fgmourao/Conditioning_Chamber/Images/15.jpeg

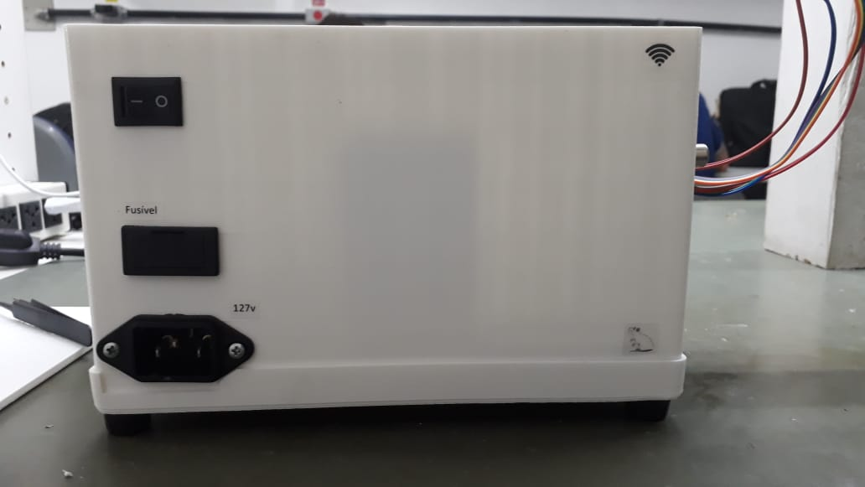
Images/15.jpeg
