fgmourao/Conditioning_Chamber/Images/17.jpeg

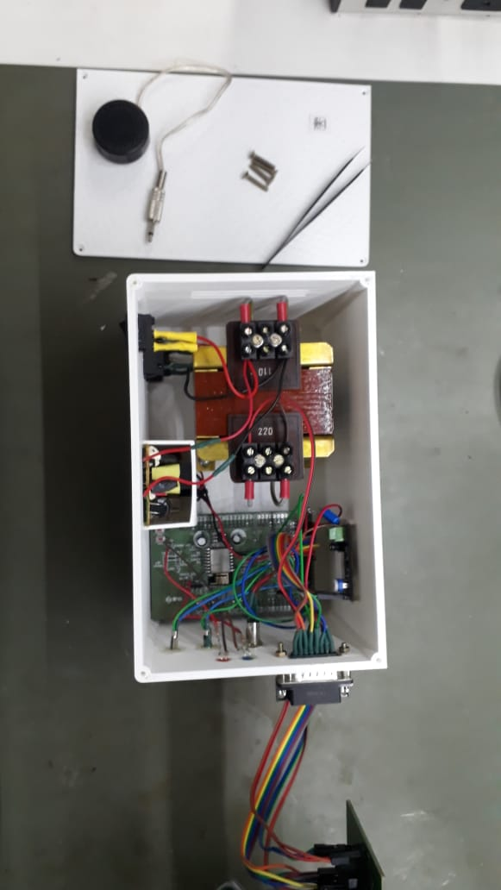
Images/17.jpeg
