fgmourao/Conditioning_Chamber/README.md

# A Custom Microcontrolled and Wireless-Operated Chamber for Auditory Fear Conditioning

Front. Neurosci., 07 November 2019<br />
Sec. Neural Technology <br />
https://doi.org/10.3389/fnins.2019.01193<br />

Correspondence:<br />

Flávio Afonso Gonçalves Mourão, PhD<br />
Núcleo de Neurociências, Departamento de Fisiologia e Biofísica<br />
Instituto de Ciências Biológicas (ICB)<br /> 
Universidade Federal de Minas Gerais (UFMG)<br />
Av. Antônio Carlos, 6627 - CEP 31270-901- Campus Pampulha<br />
Belo Horizonte - MG - Brazil<br />
Fax: +55 31 3409-2924 Phone: +55 31 3409-2927<br />
Email:  mourao.fg@gmail.com / fagm@ufmg.br <br />

Márcio Flávio Dutra Moraes, PhD<br />
Núcleo de Neurociências, Departamento de Fisiologia e Biofísica<br />
Instituto de Ciências Biológicas (ICB)<br /> 
Universidade Federal de Minas Gerais (UFMG)<br />
Av. Antônio Carlos, 6627 - CEP 31270-901- Campus Pampulha<br />
Belo Horizonte - MG - Brazil<br />
Fax: +55 31 3409-2924 Phone: +55 31 3409-2930<br />
Email: mfdm@icb.ufmg.br <br />
<br />
