fgmourao/Conditioning_Chamber/Images/02.jpeg

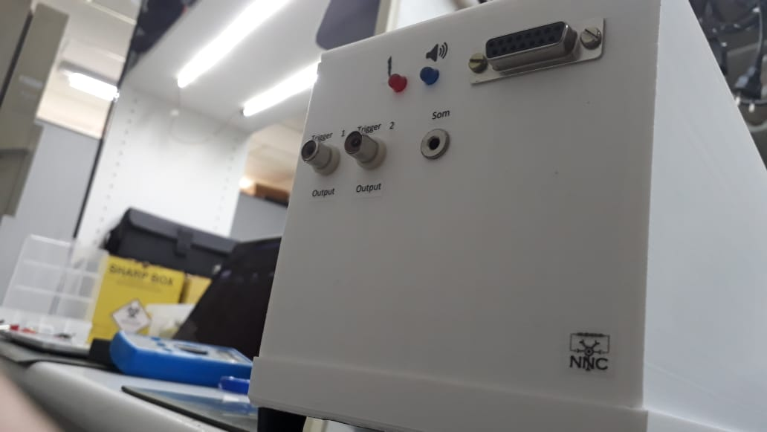
Images/02.jpeg
