fgmourao/Conditioning_Chamber/Images/03.jpeg

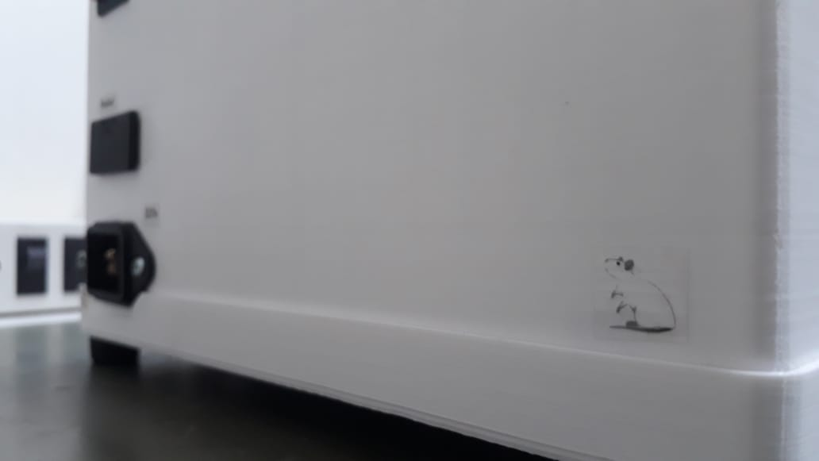
Images/03.jpeg
