fgmourao/Conditioning_Chamber/Images/04.jpeg

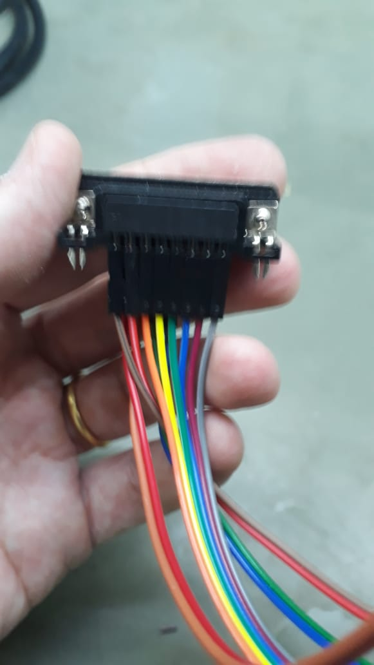
Images/04.jpeg
