fgmourao/Conditioning_Chamber/Images/06.jpeg

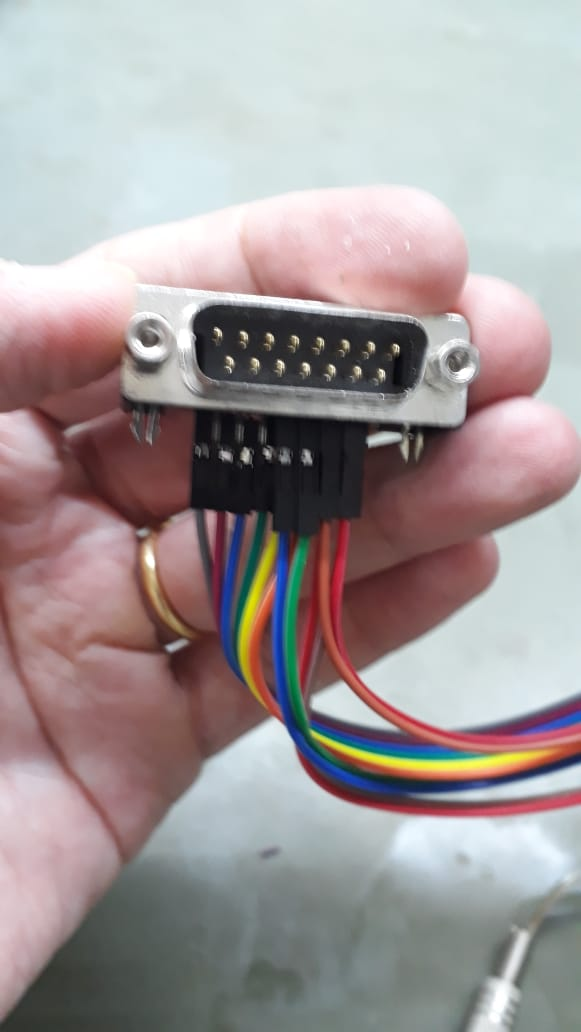
Images/06.jpeg
