fgmourao/Conditioning_Chamber/Images/11.jpeg

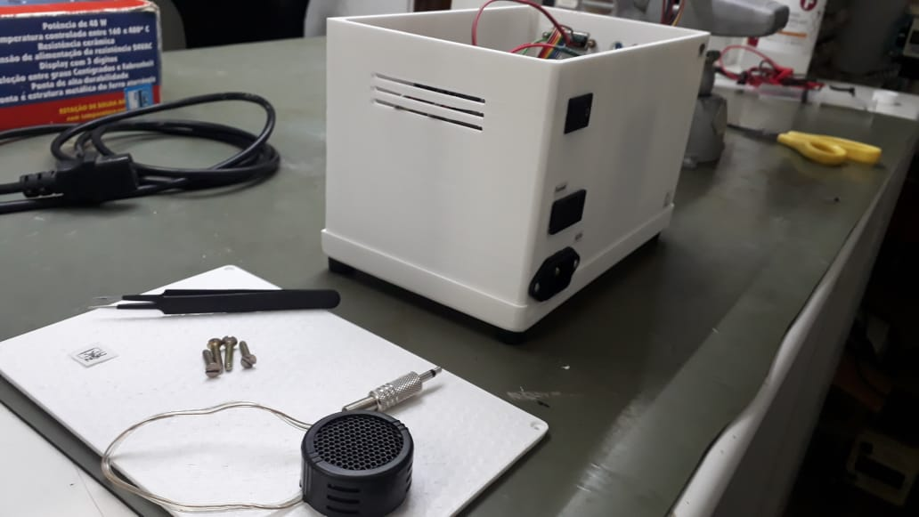
Images/11.jpeg
