fgmourao/Conditioning_Chamber/Images/12.jpeg

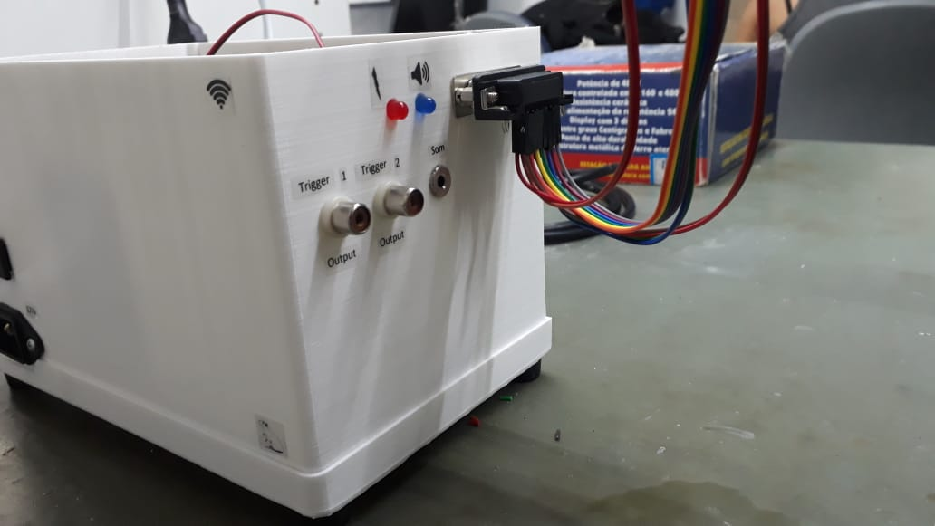
Images/12.jpeg
