fgmourao/Conditioning_Chamber/Images/13.jpeg

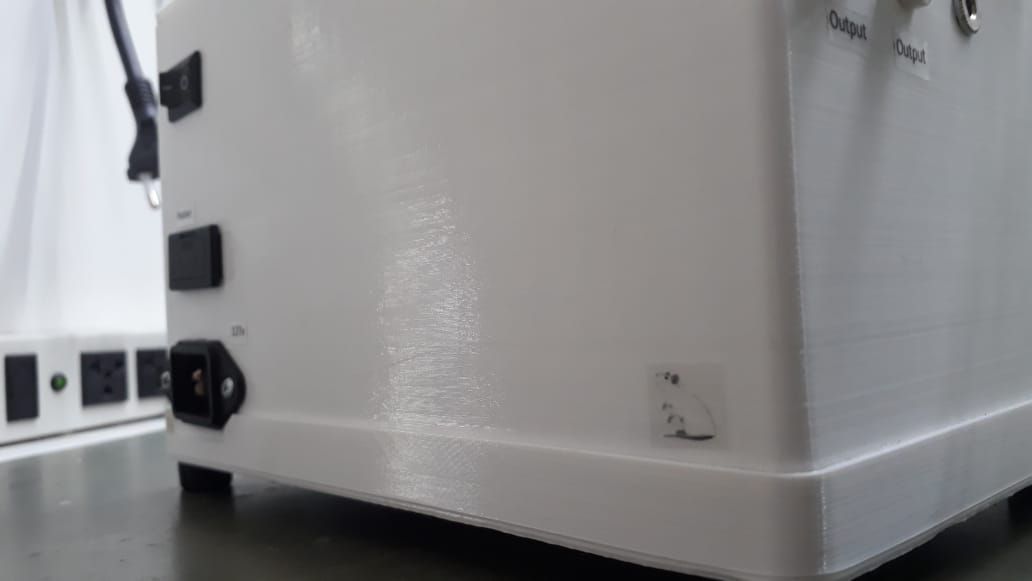
Images/13.jpeg
