fgmourao/Conditioning_Chamber/Images/14.jpeg

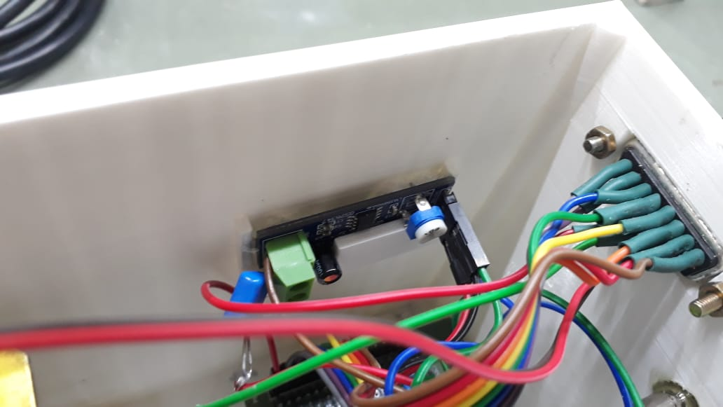
Images/14.jpeg
