fgmourao/Conditioning_Chamber/Hardware/3D/Control_box.stl

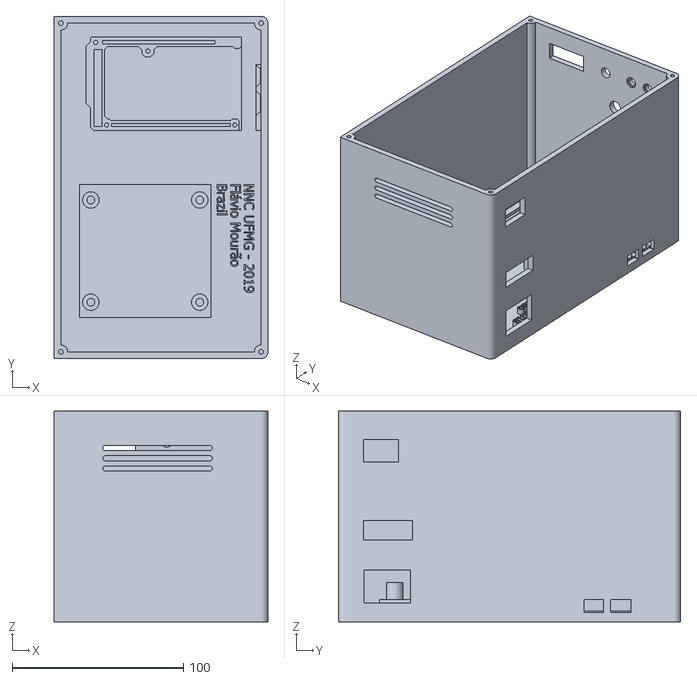
[picture p11: CAD file, 2023-06-27]
Hardware/3D/Control_box.stl
125.0 x 200.0 x 123.0
