fgmourao/Conditioning_Chamber/Hardware/3D/Control_box_roof.stl

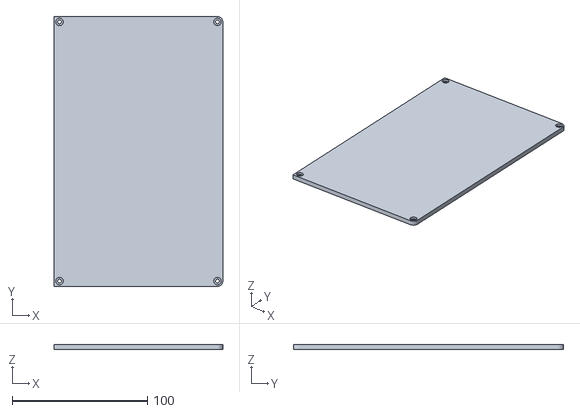
[picture p12: CAD file, 2023-06-27]
Hardware/3D/Control_box_roof.stl
125.0 x 200.0 x 3.80
