fgmourao/Conditioning_Chamber/Hardware/3D/Control_box_floor.stl

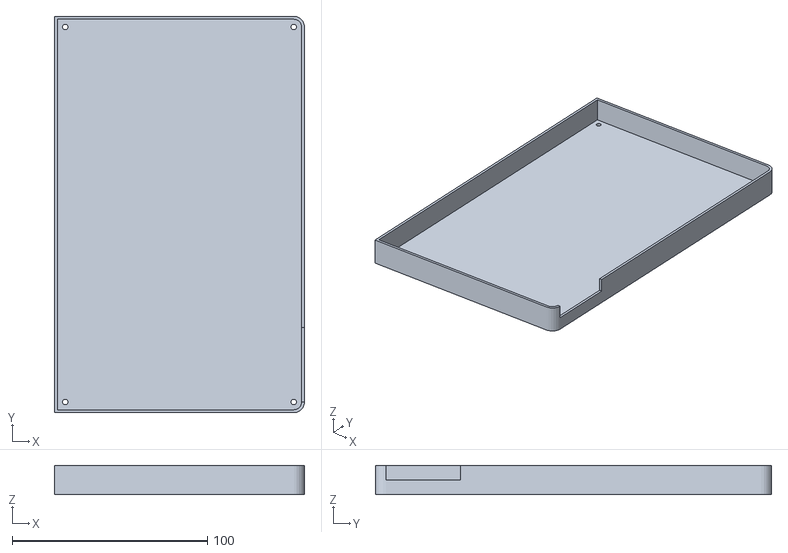
[picture p13: CAD file, 2023-06-27]
Hardware/3D/Control_box_floor.stl
128.0 x 203.0 x 15.0
