fgmourao/Conditioning_Chamber/Hardware/3D/Holder_amp.stl

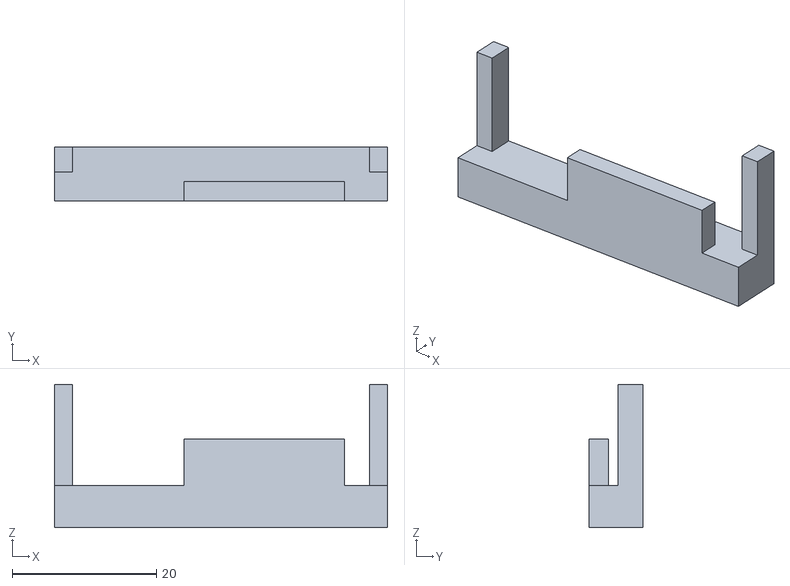
[picture p14: CAD file, 2023-06-27]
Hardware/3D/Holder_amp.stl
46.2 x 7.50 x 19.9
