fgmourao/Conditioning_Chamber/Hardware/3D/Power_supply_holder.stl

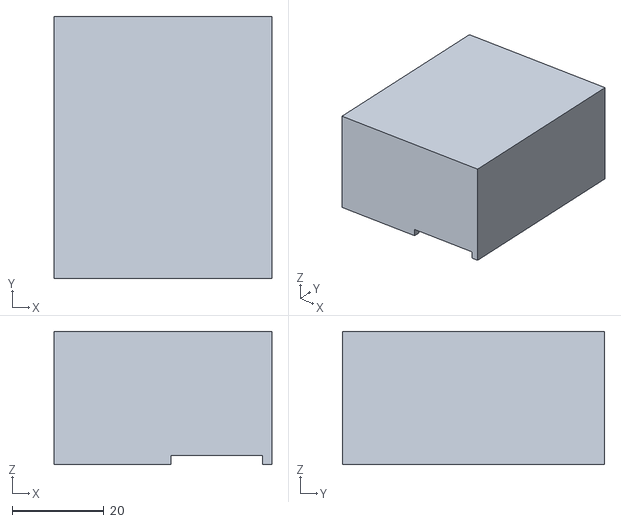
[picture p15: CAD file, 2023-06-27]
Hardware/3D/Power_supply_holder.stl
47.4 x 57.0 x 29.0
