fgmourao/Conditioning_Chamber/Manuals/Arduino  - Web_Page.png

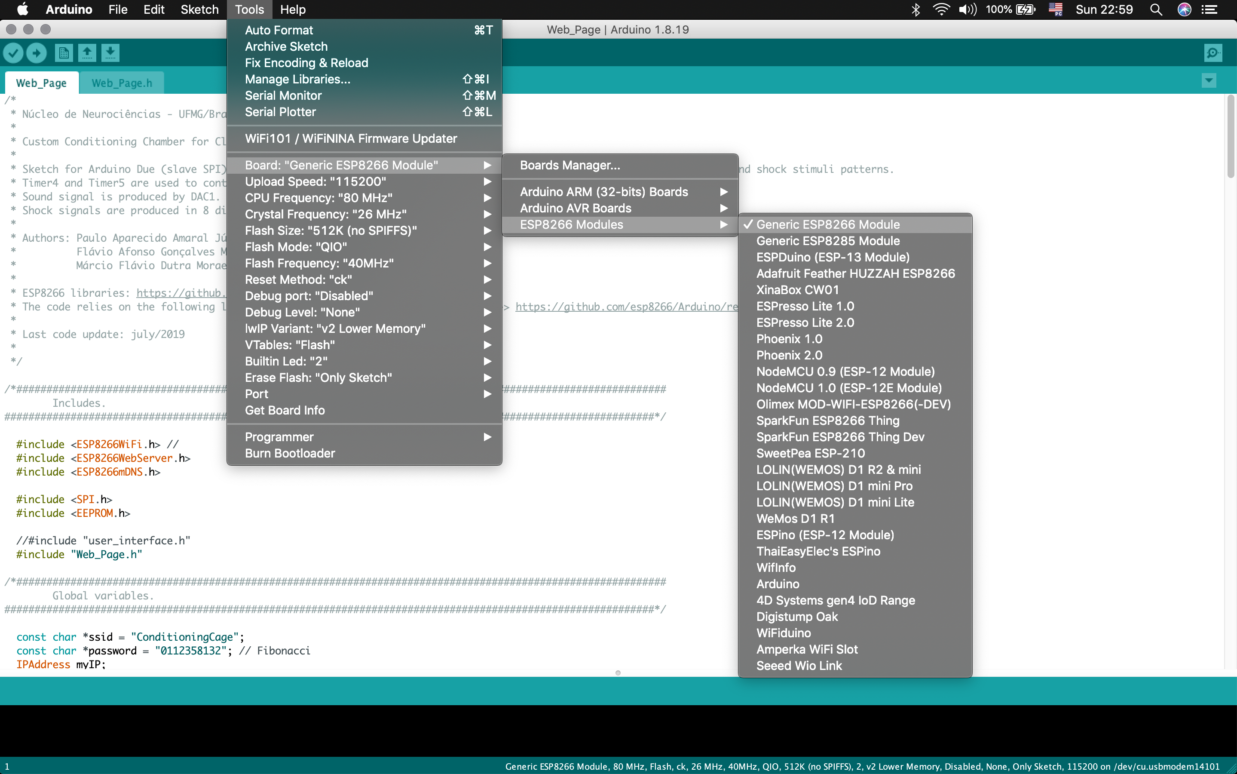
Manuals/Arduino - Web_Page.png
