fgmourao/Conditioning_Chamber/Manuals/Arduino - Stimuli.png

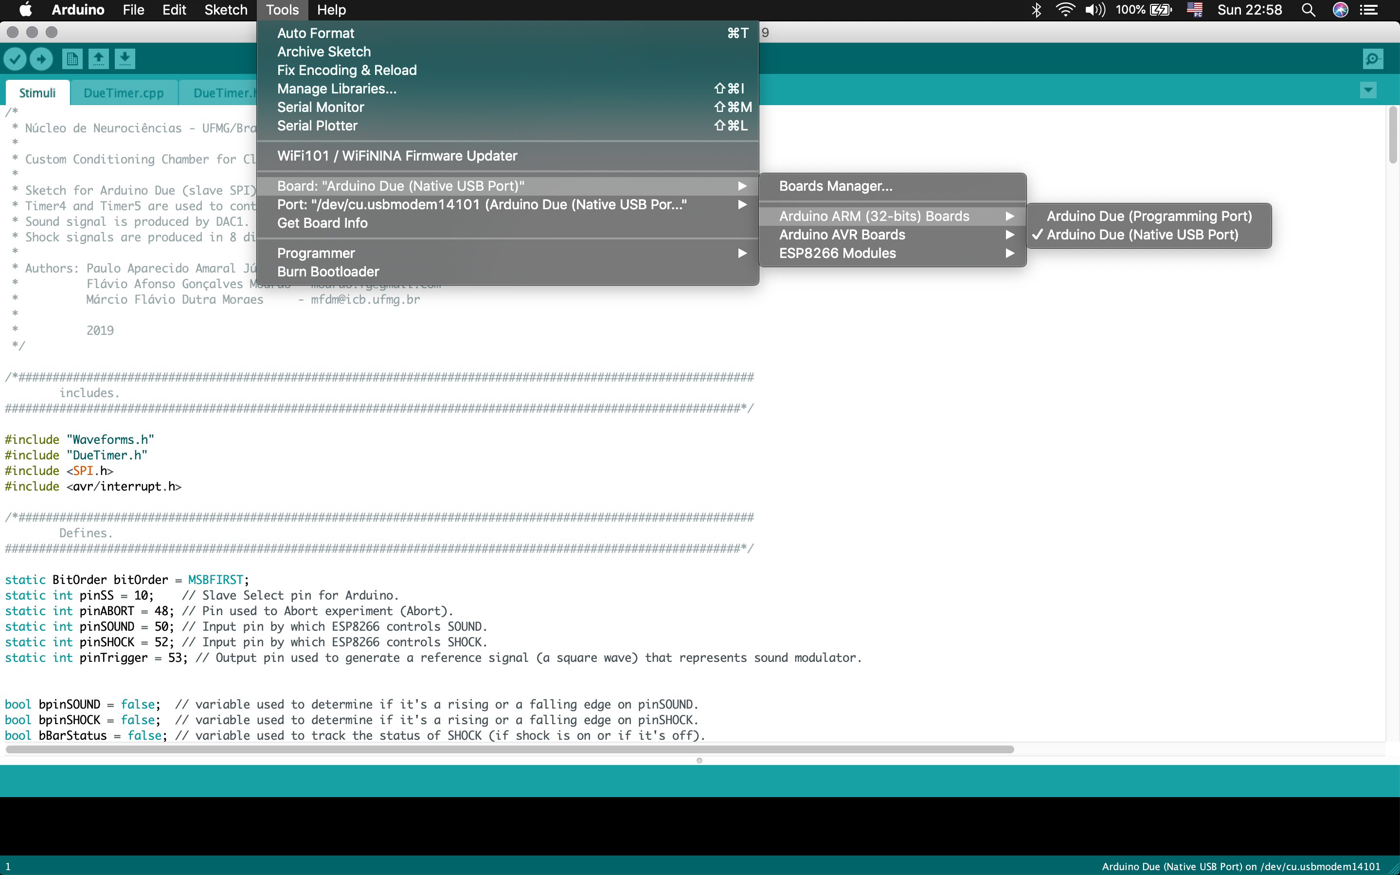
Manuals/Arduino - Stimuli.png
