fgmourao/Conditioning_Chamber/Hardware/Circuit - Kicad/Control Board/NNC_ControlBoard.kicad_pcb

## KiCad design Hardware/Circuit - Kicad/Control Board/NNC_ControlBoard.kicad_pcb (2023-06-27)

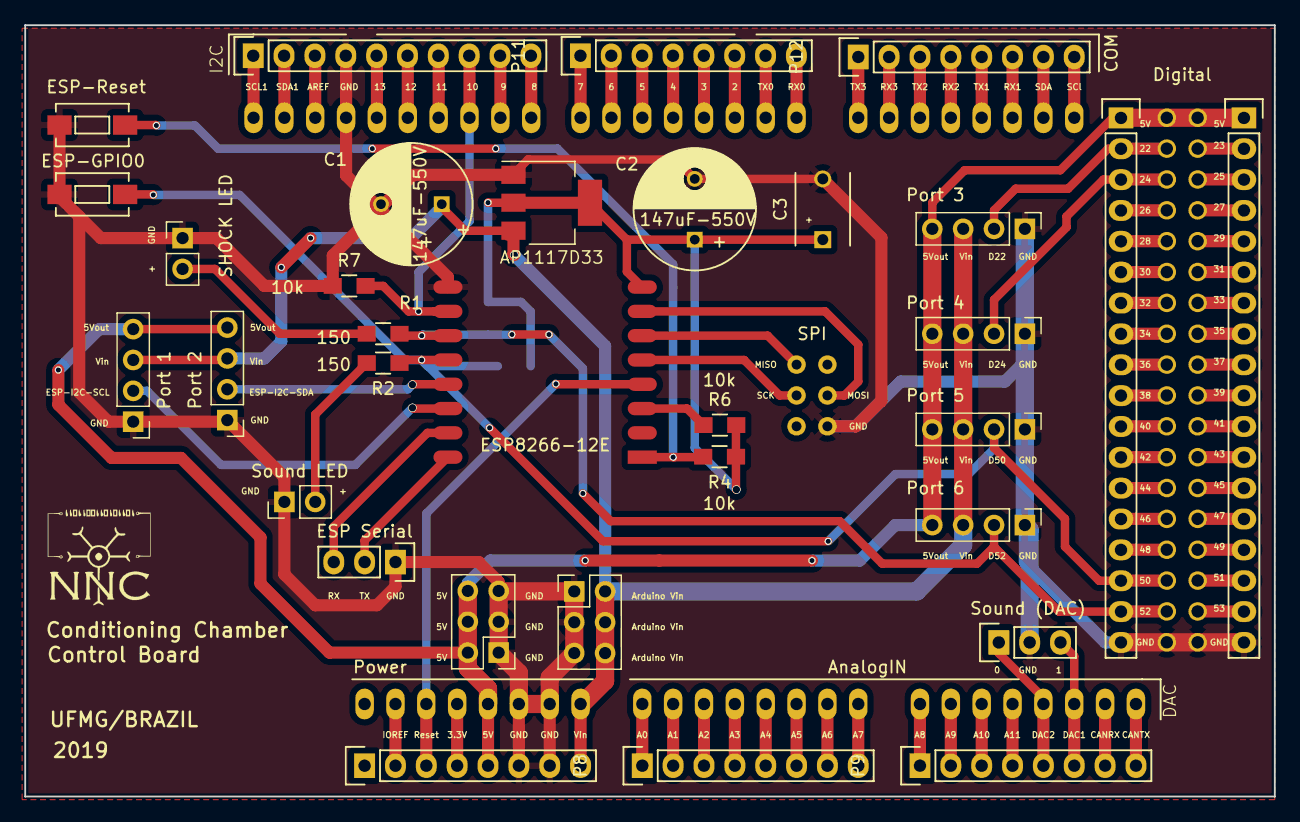
[picture p18: board NNC_ControlBoard.kicad_pcb from above]

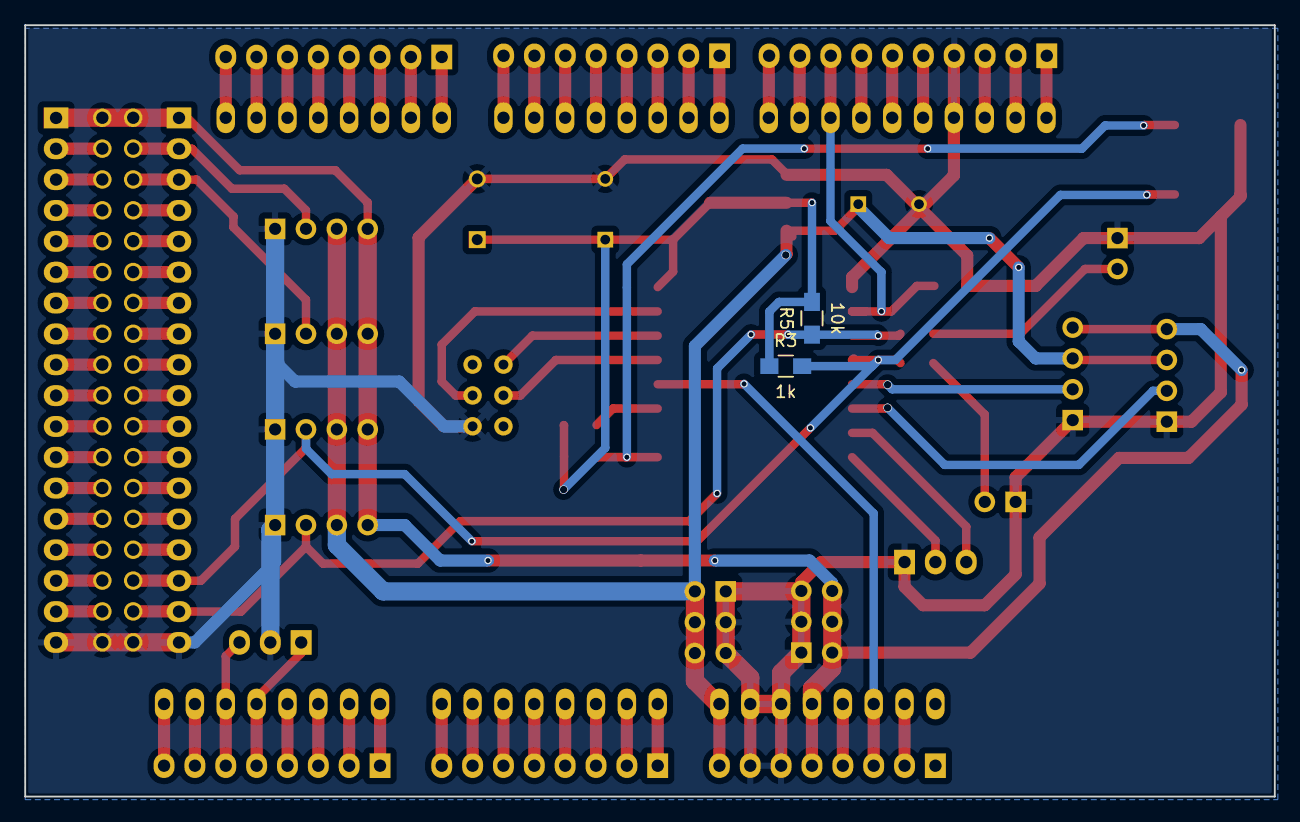
[picture p19: board NNC_ControlBoard.kicad_pcb from below]

Board: 2 copper layers, 102.9 x 63.5 mm, 35 parts (2 on the bottom side), 91 nets.

Parts:
C1, C2: 147uF-550V; C_Radial_D10_L13_P5
C3: C; C_Disc_D6_P5
Control Board: Conditioning Chamber; ARDUINO_DUE_SHIELD
D1: SHOCK LED; Pin_Header_Straight_1x02_Pitch2.54mm
D2: Sound LED; Pin_Header_Straight_1x02_Pitch2.54mm
ESP1: ESP8266-12E; ESP-12E_noBottomPads
ESP-GPIO0: 2; SW_SPST_EVQPE1
ESP-Reset: 1; SW_SPST_EVQPE1
I2C: PWM2; Pin_Header_Straight_1x10
J1: Port 6; Pin_Header_Straight_1x04_Pitch2.54mm
J2: Port 2; Pin_Header_Straight_1x04_Pitch2.54mm
J3: Port 3; Pin_Header_Straight_1x04_Pitch2.54mm
J4: Port 4; Pin_Header_Straight_1x04_Pitch2.54mm
J5: Port 5; Pin_Header_Straight_1x04_Pitch2.54mm
J6: Port 1; Pin_Header_Straight_1x04_Pitch2.54mm
J7: Arduino Vin; Pin_Header_Straight_2x03_Pitch2.54mm
J8: 5V; Pin_Header_Straight_2x03_Pitch2.54mm
P3: Sound (DAC); Pin_Header_Straight_1x03
P4: ESP Serial; Pin_Header_Straight_1x03
P5: DIG1; Pin_Header_Straight_1x18
P6: DIG2; Pin_Header_Straight_1x18
P7: Power; Pin_Header_Straight_1x08
P8: AnalogIN; Pin_Header_Straight_1x08
P9: DAC; Pin_Header_Straight_1x08
P11: PWM1; Pin_Header_Straight_1x08
P12: COM; Pin_Header_Straight_1x08
R1, R2: 150; R_0805_HandSoldering
R3: 1k; R_0805_HandSoldering
R4, R5, R6, R7: 10k; R_0805_HandSoldering
U1: AP1117D33; SOT-223-3_TabPin2

Connections:
/5Voutput: Control Board.5V, Control Board.5V_4, Control Board.5V_5, J1.4, J2.4, J3.4, J4.4, J5.4, J6.4, J8.2, J8.4, J8.6, P5.1, P6.1, P7.5
/Arduino_Vin: C1.1, Control Board.V_IN, J1.3, J2.3, J3.3, J4.3, J5.3, J6.3, J7.2, J7.4, J7.6, P7.8, U1.3
/D22: Control Board.22, J3.2, P5.2
/D23: Control Board.23, P6.2
/D24: Control Board.24, J4.2, P5.3
/D25: Control Board.25, P6.3
/D26: Control Board.26, P5.4
/D27: Control Board.27, P6.4
/D28: Control Board.28, P5.5
/D29: Control Board.29, P6.5
/D30: Control Board.30, P5.6
/D31: Control Board.31, P6.6
/D32: Control Board.32, P5.7
/D33: Control Board.33, P6.7
/D34: Control Board.34, P5.8
/D35: Control Board.35, P6.8
/D36: Control Board.36, P5.9
/D37: Control Board.37, P6.9
/D38: Control Board.38, P5.10
/D39: Control Board.39, P6.10
/D40: Control Board.40, P5.11
/D41: Control Board.41, P6.11
/D42: Control Board.42, P5.12
/D43: Control Board.43, P6.12
/D44: Control Board.44, P5.13
/D45: Control Board.45, P6.13
/D46: Control Board.46, P5.14
/D47: Control Board.47, P6.14
/D48: Control Board.48, P5.15
/D49: Control Board.49, P6.15
/D50: Control Board.50, ESP1.18, ESP-GPIO0.1, J5.2, P5.16, R2.1, R3.2
/D51: Control Board.51, P6.16
/D52: Control Board.52, ESP1.17, J1.2, P5.17, R1.1, R5.1
/D53: Control Board.53, P6.17
/DAC0: Control Board.DAC0, P3.1, P9.5
/DAC1: Control Board.DAC1, P3.3, P9.6
/ESP12Econfig/ESPchpd: ESP1.3, R6.1
/ESP12Econfig/ESPrst: ESP1.1, ESP-Reset.1, R4.2
/ESP12Econfig/VDD3V: C2.1, C3.1, ESP1.8, R3.1, R4.1, R5.2, R6.2, U1.2
/ESP_CS: Control Board.10, ESP1.16, I2C.8, R7.2
/ESP_GPIO16: Control Board.RST, ESP1.4, P7.3
/ESP_I2C_SCL: ESP1.20, J6.2
/ESP_I2C_SDA: ESP1.19, J2.2
/ESP_MISO: Control Board.SP1, ESP1.6
/ESP_MOSI: Control Board.SP4, ESP1.7
/ESP_RX: ESP1.21, P4.3
/ESP_SCK: Control Board.SP3, ESP1.5
/ESP_TX: ESP1.22, P4.2
/GND: C1.2, C2.2, C3.2, Control Board.GND1, Control Board.GND2, Control Board.GND3, Control Board.GND4, Control Board.GND5, Control Board.SP6, D1.1, D2.1, ESP1.15, ESP-GPIO0.2, ESP-Reset.2, I2C.4, J1.1, J2.1, J3.1, J4.1, J5.1, J6.1, J7.1, J7.3, J7.5, J8.1, J8.3, J8.5, P3.2, P4.1, P5.18, P6.18, P7.6, P7.7, R7.1, U1.1
unnamed: D1.2, R1.2
unnamed: D2.2, R2.2
unnamed: Control Board.IO_R, P7.2
unnamed: Control Board.3V3, P7.4
unnamed: Control Board.AD0, P8.1
unnamed: Control Board.AD1, P8.2
unnamed: Control Board.AD2, P8.3
unnamed: Control Board.AD3, P8.4
unnamed: Control Board.AD4, P8.5
unnamed: Control Board.AD5, P8.6
unnamed: Control Board.AD6, P8.7
unnamed: Control Board.AD7, P8.8
unnamed: Control Board.AD8, P9.1
unnamed: Control Board.AD9, P9.2
unnamed: Control Board.AD10, P9.3
unnamed: Control Board.AD11, P9.4
unnamed: Control Board.C_RX, P9.7
unnamed: Control Board.C_TX, P9.8
unnamed: Control Board.SCL1, I2C.1
unnamed: Control Board.SDA1, I2C.2
unnamed: Control Board.AREF, I2C.3
unnamed: Control Board.13, I2C.5
unnamed: Control Board.12, I2C.6
unnamed: Control Board.11, I2C.7
unnamed: Control Board.9, I2C.9
unnamed: Control Board.8, I2C.10
unnamed: Control Board.7, P11.1
unnamed: Control Board.6, P11.2
unnamed: Control Board.5, P11.3
unnamed: Control Board.4, P11.4
unnamed: Control Board.3, P11.5
unnamed: Control Board.2, P11.6
unnamed: Control Board.1, P11.7
unnamed: Control Board.0, P11.8
unnamed: Control Board.14, P12.1
unnamed: Control Board.15, P12.2
unnamed: Control Board.16, P12.3
unnamed: Control Board.17, P12.4
unnamed: Control Board.18, P12.5
unnamed: Control Board.19, P12.6
unnamed: Control Board.20, P12.7
unnamed: Control Board.21, P12.8
