fgmourao/Conditioning_Chamber/Hardware/Circuit - Kicad/Shock Board/NNC_ShockBoard.kicad_pcb

## KiCad design Hardware/Circuit - Kicad/Shock Board/NNC_ShockBoard.kicad_pcb (2023-06-27)

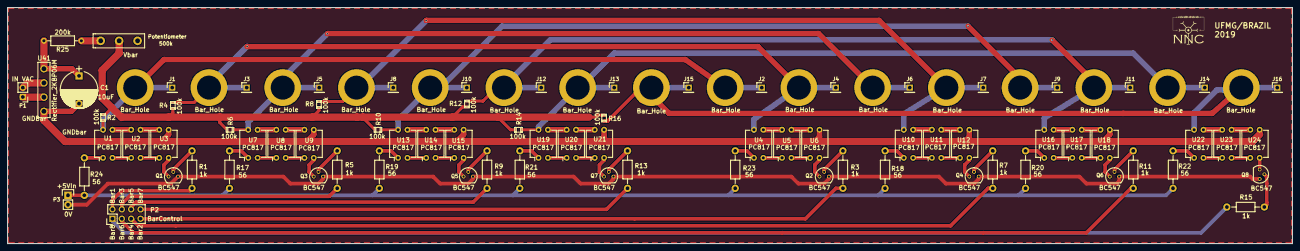
[picture p20: board NNC_ShockBoard.kicad_pcb from above]

Board: 2 copper layers, 348.5 x 64.0 mm, 95 parts (0 on the bottom side), 80 nets.

Parts:
C1: 10uF; CP_Radial_D10.0mm_P7.50mm
J1, J2, J3, J4, J5, J6, J7, J8, J9, J10, J11, J12, J13, J14, J15, J16: Conn_01x01; Pin_Header_Straight_1x01_Pitch2.54mm
P1: IN VAC; Pin_Header_Straight_1x02_Pitch2.54mm
P2: CONN_01X08; Pin_Header_Straight_2x04
P3: 5VDC In; Pin_Header_Straight_1x02
Potentiometer: 500k; Potentiometer_Alps_RK163_Single_Vertical
Q1, Q2, Q3, Q4, Q5, Q6, Q7, Q8: BC547; TO-92_Molded_Narrow
R1, R3, R5, R7, R9, R11, R13, R15: 1k; Resistor_Horizontal_RM10mm
R2, R4, R6, R8, R10, R12, R14, R16: 100k; SMD_0805
R17, R18, R19, R20, R21, R22, R23, R24: 56; Resistor_Horizontal_RM10mm
R25: 200k; R_Axial_DIN0207_L6.3mm_D2.5mm_P10.16mm_Horizontal
U1, U2, U3, U4, U5, U6, U7, U8, U9, U10, U11, U12, U13, U14, U15, U16, U17, U18, U19, U20, U21, U22, U23, U24: PC817; DIP-4_W7.62mm
U25, U26, U27, U28, U29, U30, U31, U32, U33, U34, U35, U36, U37, U38, U39, U40: Bar_Hole
U41: Rectifier_2KBP06M

Connections:
5V_Arduino: P3.1, R17.2, R18.2, R19.2, R20.2, R21.2, R22.2, R23.2, R24.2
/InBarra1: P2.2, R1.2
/InBarra2: P2.7, R3.2
/InBarra3: P2.4, R5.2
/InBarra4: P2.5, R7.2
/InBarra5: P2.6, R9.2
/InBarra6: P2.3, R11.2
/InBarra7: P2.8, R13.2
/InBarra8: P2.1, R15.2
/OutBarra1: J1.1, J2.1, R2.2, U1.4, U25.1, U33.1
/OutBarra2: J3.1, J4.1, R4.2, U4.4, U26.1, U34.1
/OutBarra3: J5.1, J6.1, R6.2, U7.4, U27.1, U35.1
/OutBarra4: J7.1, J8.1, R8.2, U10.4, U28.1, U36.1
/OutBarra5: J9.1, J10.1, R10.2, U13.4, U29.1, U37.1
/OutBarra6: J11.1, J12.1, R12.2, U16.4, U30.1, U38.1
/OutBarra7: J13.1, J14.1, R14.2, U19.4, U31.1, U39.1
/OutBarra8: J15.1, J16.1, R16.2, U22.4, U32.1, U40.1
/Vtrafo+: P1.1, U41.3
/Vtrafo-: P1.2, U41.2
GndArduino: P3.2, Q1.3, Q2.3, Q3.3, Q4.3, Q5.3, Q6.3, Q7.3, Q8.3
GndBarra: C1.2, U3.3, U6.3, U9.3, U12.3, U15.3, U18.3, U21.3, U24.3, U41.4
unnamed: C1.1, R25.2, U41.1
unnamed: Q1.1, U3.2
unnamed: Q1.2, R1.1
unnamed: Q2.1, U6.2
unnamed: Q2.2, R3.1
unnamed: Q3.1, U9.2
unnamed: Q3.2, R5.1
unnamed: Q4.1, U12.2
unnamed: Q4.2, R7.1
unnamed: Q5.1, U15.2
unnamed: Q5.2, R9.1
unnamed: Q6.1, U18.2
unnamed: Q6.2, R11.1
unnamed: Q7.1, U21.2
unnamed: Q7.2, R13.1
unnamed: Q8.1, U24.2
unnamed: Q8.2, R15.1
unnamed: R17.1, U7.1
unnamed: R18.1, U10.1
unnamed: R19.1, U13.1
unnamed: R20.1, U16.1
unnamed: R21.1, U19.1
unnamed: R22.1, U22.1
unnamed: R23.1, U4.1
unnamed: R24.1, U1.1
unnamed: Potentiometer.3, R25.1
unnamed: U1.2, U2.1
unnamed: U1.3, U2.4
unnamed: U2.2, U3.1
unnamed: U2.3, U3.4
unnamed: U4.2, U5.1
unnamed: U4.3, U5.4
unnamed: U5.2, U6.1
unnamed: U5.3, U6.4
unnamed: U7.2, U8.1
unnamed: U7.3, U8.4
unnamed: U8.2, U9.1
unnamed: U8.3, U9.4
unnamed: U10.2, U11.1
unnamed: U10.3, U11.4
unnamed: U11.2, U12.1
unnamed: U11.3, U12.4
unnamed: U13.2, U14.1
unnamed: U13.3, U14.4
unnamed: U14.2, U15.1
unnamed: U14.3, U15.4
unnamed: U16.2, U17.1
unnamed: U16.3, U17.4
unnamed: U17.2, U18.1
unnamed: U17.3, U18.4
unnamed: U19.2, U20.1
unnamed: U19.3, U20.4
unnamed: U20.2, U21.1
unnamed: U20.3, U21.4
unnamed: U22.2, U23.1
unnamed: U22.3, U23.4
unnamed: U23.2, U24.1
unnamed: U23.3, U24.4
Vbarra: Potentiometer.2, R2.1, R4.1, R6.1, R8.1, R10.1, R12.1, R14.1, R16.1
